JonasRadtke/GB-Akku/doc/connectorboard.jpg

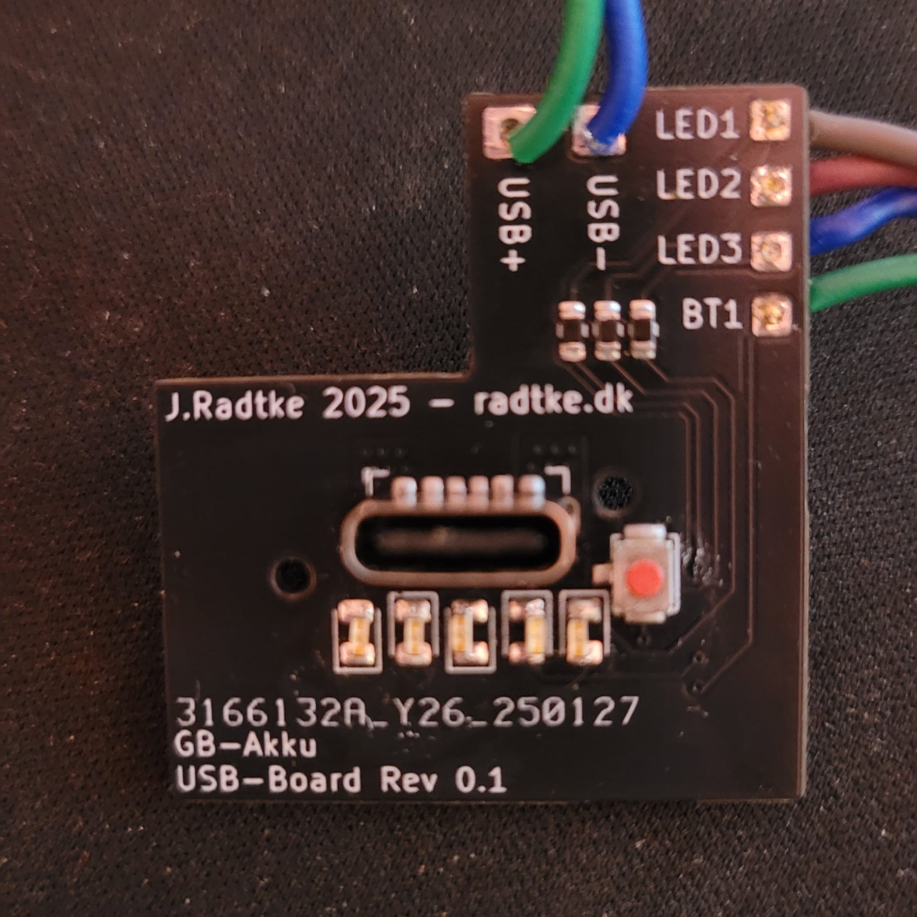
doc/connectorboard.jpg
