JonasRadtke/GB-Akku/doc/vorher.jpg

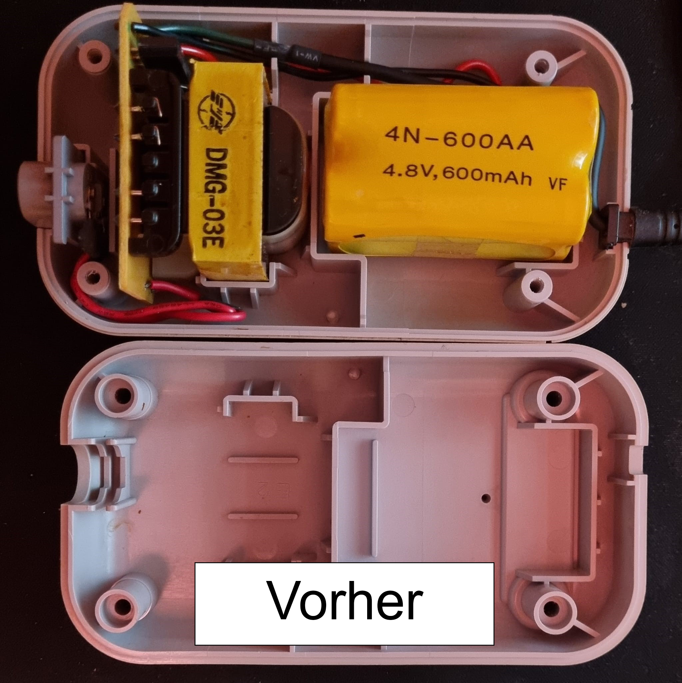
doc/vorher.jpg
