JonasRadtke/GB-Akku/doc/board.jpg

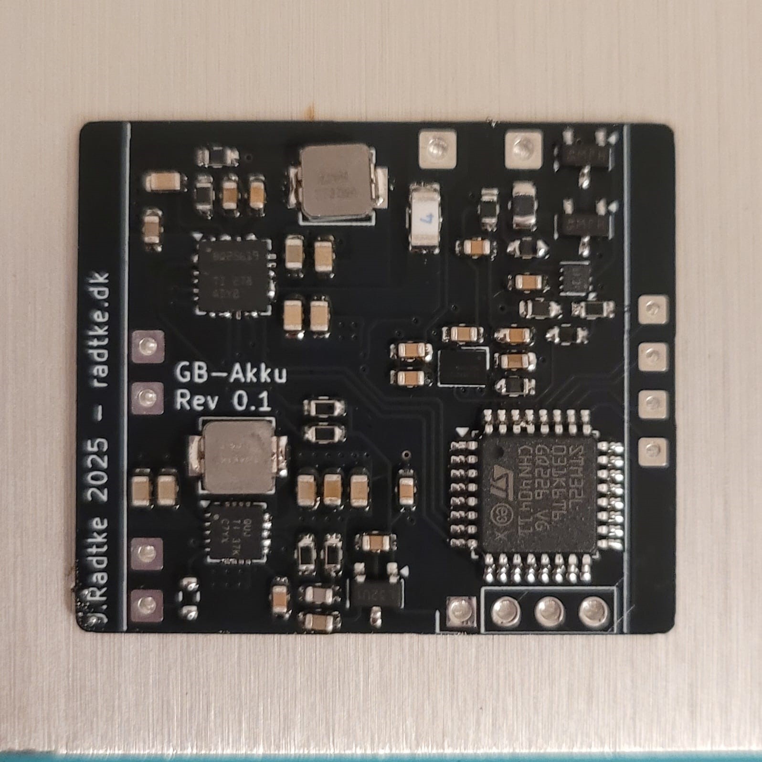
doc/board.jpg
