JonasRadtke/GB-Akku/doc/connector.jpg

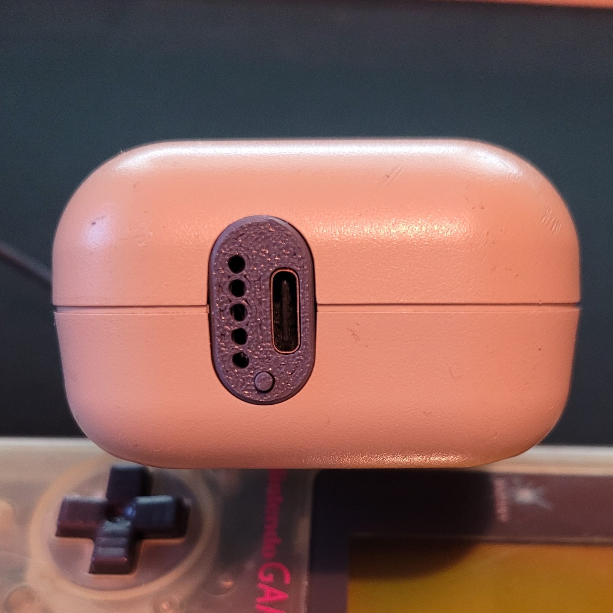
doc/connector.jpg
