JonasRadtke/GB-Akku/doc/nachher.jpg

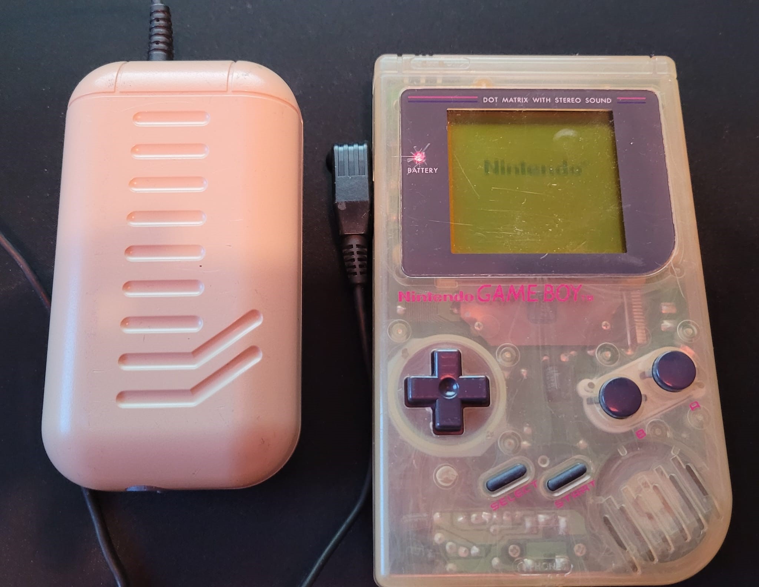
doc/nachher.jpg
