JonasRadtke/GB-Akku/doc/opend.jpg

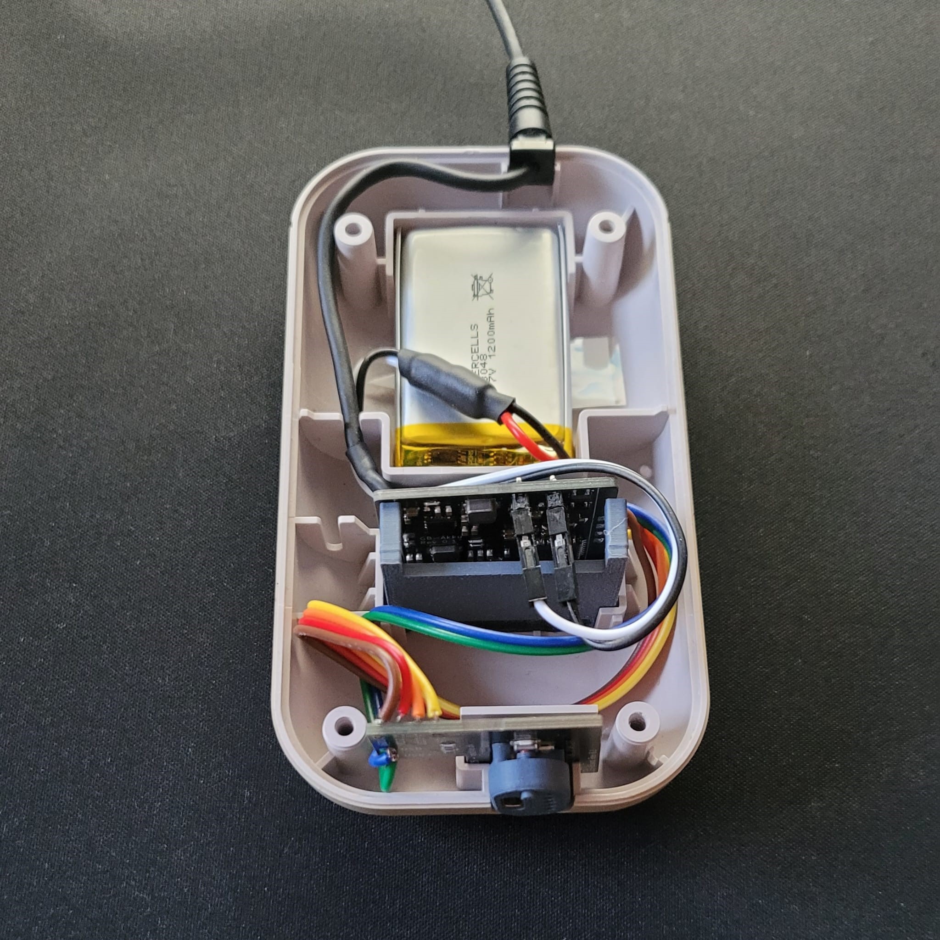
doc/opend.jpg
