JonasRadtke/GB-Akku/GB-Akku.kicad_pcb

## KiCad design GB-Akku.kicad_pcb (2025-02-14)

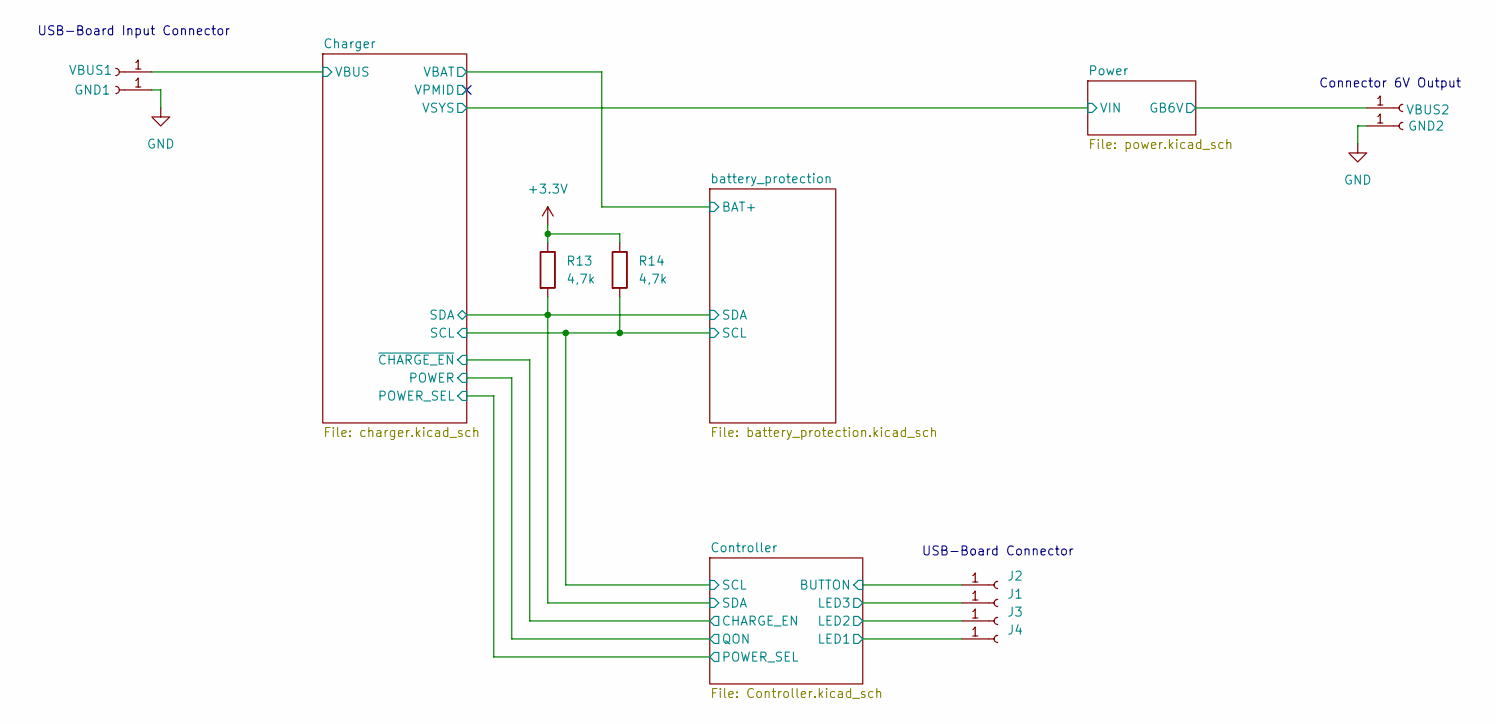
[picture p7: schematic GB-Akku.kicad_sch]

Parts:
GND1, GND2: +; SolderWire-0.25sqmm_1x01_D0.65mm_OD1.7mm
J1, J2, J3, J4: Conn_01x01_Socket; SolderWire-0.1sqmm_1x01_D0.4mm_OD1mm
R13, R14: 4,7k; R_0603_1608Metric
VBUS1, VBUS2: +; SolderWire-0.25sqmm_1x01_D0.65mm_OD1.7mm

Connections:
+3.3V: R13.1, R14.1; also elsewhere on the board
+6V: VBUS2.1; also elsewhere on the board
/Charger/SCL: R14.2; also elsewhere on the board
/Charger/SDA: R13.2; also elsewhere on the board
/Charger/VBUS: VBUS1.1; also elsewhere on the board
/Controller/BUTTON: J2.1; also elsewhere on the board
/Controller/LED1: J4.1; also elsewhere on the board
/Controller/LED2: J3.1; also elsewhere on the board
/Controller/LED3: J1.1; also elsewhere on the board
GND: GND1.1, GND2.1; also elsewhere on the board

Notes on the sheet:
Connector 6V Output
USB-Board Input Connector
USB-Board Connector

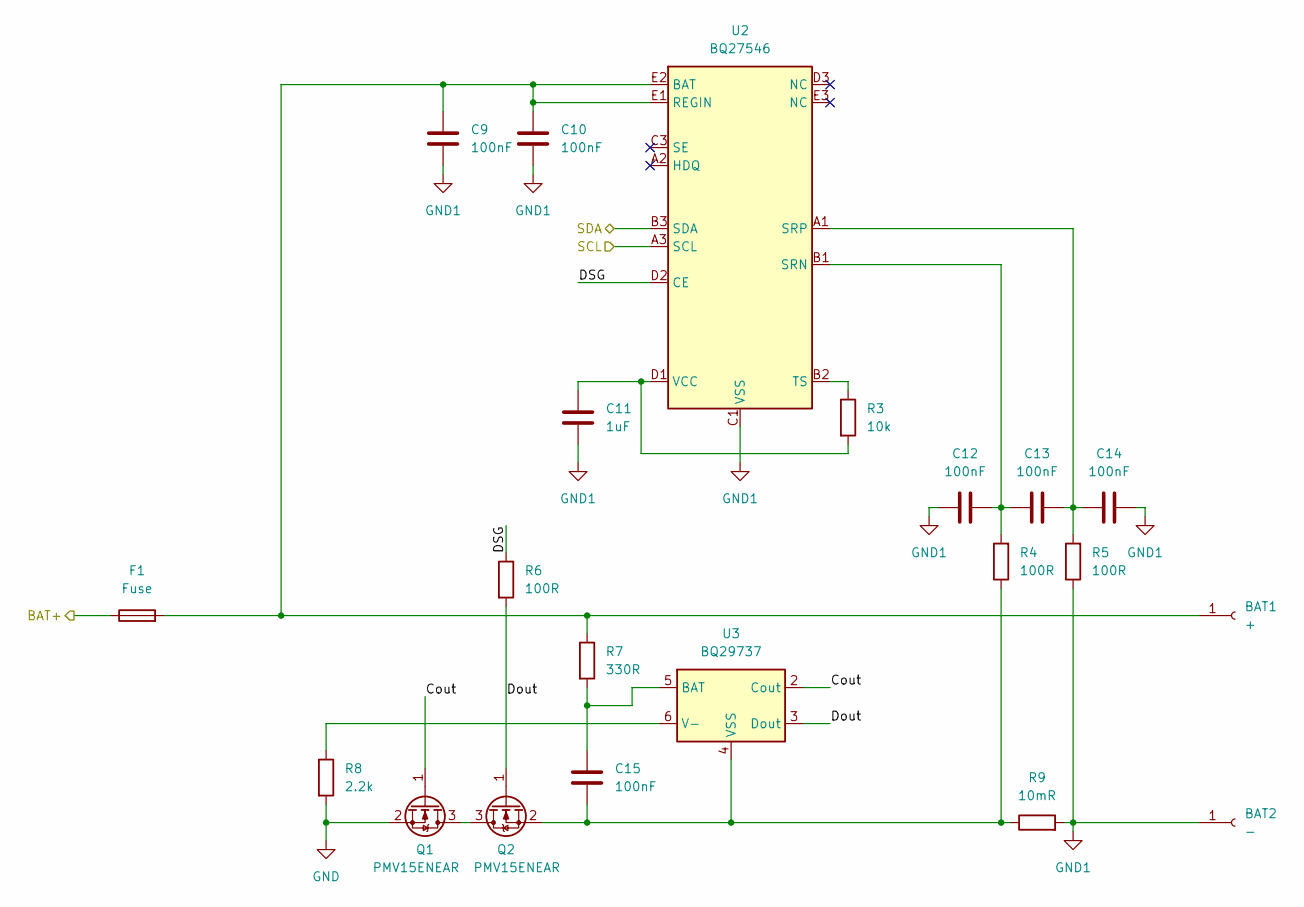
[picture p8: schematic battery_protection.kicad_sch]

Parts:
BAT1: +; SolderWire-0.5sqmm_1x01_D0.9mm_OD2.1mm
BAT2: -; SolderWire-0.5sqmm_1x01_D0.9mm_OD2.1mm
C9, C10, C12, C13, C14, C15: 100nF; C_0603_1608Metric
C11: 1uF; C_0603_1608Metric
F1: Fuse; Fuse_1206_3216Metric
Q1, Q2: PMV15ENEAR; SOT-23
R3: 10k; R_0603_1608Metric
R4, R5, R6: 100R; R_0603_1608Metric
R7: 330R; R_0603_1608Metric
R8: 2.2k; R_0603_1608Metric
R9: 10mR; R_0805_2012Metric
U2: BQ27546; DSBGA-15_1.95x2.6mm_P0.5mm_special
U3: BQ29737; WSON-6_1.5x1.5mm_P0.5mm

Connections:
/Charger/SCL: U2.A3 (SCL); also elsewhere on the board
/Charger/SDA: U2.B3 (SDA); also elsewhere on the board
/battery_protection/Cout: Q1.1 (G), U3.2 (Cout)
/battery_protection/DSG: R6.1, U2.D2 (CE)
/battery_protection/Dout: Q2.1 (G), R6.2, U3.3 (Dout)
BAT: F1.1; also elsewhere on the board
GND: Q1.2 (S), R8.2; also elsewhere on the board
GND1: BAT2.1, C9.2, C10.2, C11.2, C12.1, C14.2, R5.1, R9.2, U2.C1 (VSS), U2.C2 (VSS)
unnamed: BAT1.1, C9.1, C10.1, F1.2, R7.1, U2.E1 (REGIN), U2.E2 (BAT)
unnamed: Q1.3 (D), Q2.3 (D)
unnamed: C15.2, Q2.2 (S), R4.1, R9.1, U3.4 (VSS)
unnamed: C12.2, C13.1, R4.2, U2.B1 (SRN)
unnamed: C13.2, C14.1, R5.2, U2.A1 (SRP)
unnamed: R3.1, U2.B2 (TS)
unnamed: C11.1, R3.2, U2.D1 (VCC)
unnamed: C15.1, R7.2, U3.5 (BAT)
unnamed: R8.1, U3.6 (V-)

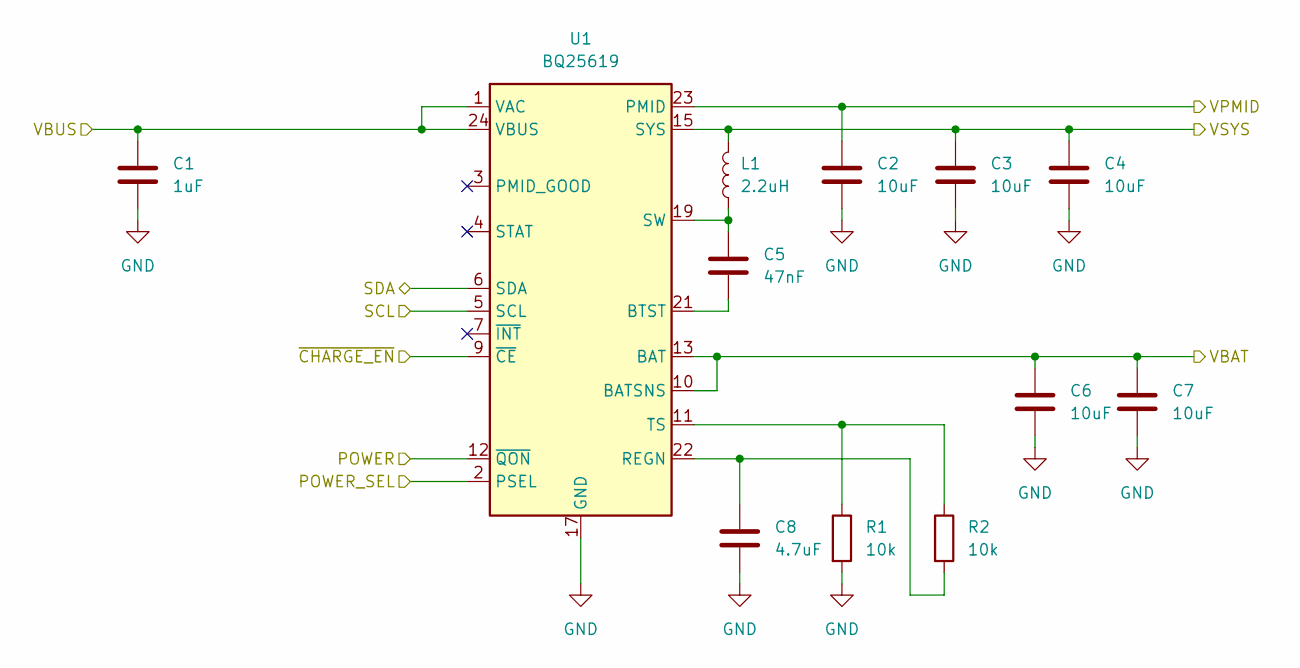
[picture p9: schematic charger.kicad_sch]

Parts:
C1: 1uF; C_0603_1608Metric
C2, C3, C4, C6, C7: 10uF; C_0603_1608Metric
C5: 47nF; C_0603_1608Metric
C8: 4.7uF; C_0603_1608Metric
L1: 2.2uH; L_Vishay_IHLP-1616
R1, R2: 10k; R_0603_1608Metric
U1: BQ25619; WQFN-24-1EP_4x4mm_P0.5mm_EP2.6x2.6mm_ThermalVias

Connections:
/Charger/POWER: U1.12 (~QON); also elsewhere on the board
/Charger/POWER_SEL: U1.2 (PSEL); also elsewhere on the board
/Charger/SCL: U1.5 (SCL); also elsewhere on the board
/Charger/SDA: U1.6 (SDA); also elsewhere on the board
/Charger/VBUS: C1.1, U1.1 (VAC), U1.24 (VBUS); also elsewhere on the board
/Charger/VPMID: C2.1, U1.23 (PMID)
/Charger/VSYS: C3.1, C4.1, L1.2, U1.15 (SYS), U1.16 (SYS); also elsewhere on the board
/Charger/~CHARGE_EN: U1.9 (~CE); also elsewhere on the board
BAT: C6.1, C7.1, U1.10 (BATSNS), U1.13 (BAT), U1.14 (BAT); also elsewhere on the board
GND: C1.2, C2.2, C3.2, C4.2, C6.2, C7.2, C8.2, R1.2, U1.17 (GND), U1.18 (GND), U1.25 (GND); also elsewhere on the board
unnamed: C5.1, L1.1, U1.19 (SW), U1.20 (SW)
unnamed: C5.2, U1.21 (BTST)
unnamed: C8.1, R2.2, U1.22 (REGN)
unnamed: R1.1, R2.1, U1.11 (TS)

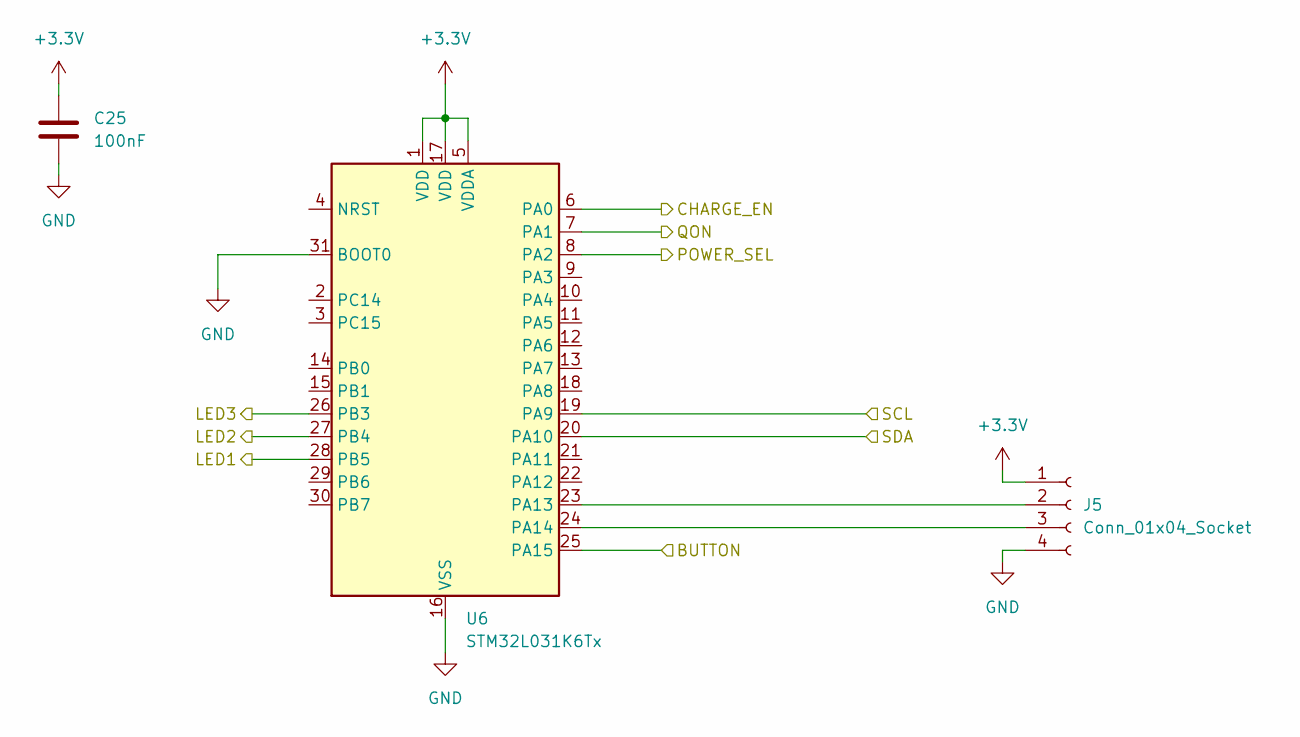
[picture p10: schematic Controller.kicad_sch]

Parts:
C25: 100nF; C_0603_1608Metric
J5: Conn_01x04_Socket; PinHeader_1x04_P2.54mm_Vertical
U6: STM32L031K6Tx; LQFP-32_7x7mm_P0.8mm

Connections:
+3.3V: C25.1, J5.1, U6.1 (VDD), U6.5 (VDDA), U6.17 (VDD); also elsewhere on the board
/Charger/POWER: U6.7 (PA1); also elsewhere on the board
/Charger/POWER_SEL: U6.8 (PA2); also elsewhere on the board
/Charger/SCL: U6.19 (PA9); also elsewhere on the board
/Charger/SDA: U6.20 (PA10); also elsewhere on the board
/Charger/~CHARGE_EN: U6.6 (PA0); also elsewhere on the board
/Controller/BUTTON: U6.25 (PA15); also elsewhere on the board
/Controller/LED1: U6.28 (PB5); also elsewhere on the board
/Controller/LED2: U6.27 (PB4); also elsewhere on the board
/Controller/LED3: U6.26 (PB3); also elsewhere on the board
GND: C25.2, J5.4, U6.16 (VSS), U6.31 (BOOT0), U6.32 (VSS); also elsewhere on the board
unnamed: J5.2, U6.23 (PA13)
unnamed: J5.3, U6.24 (PA14)

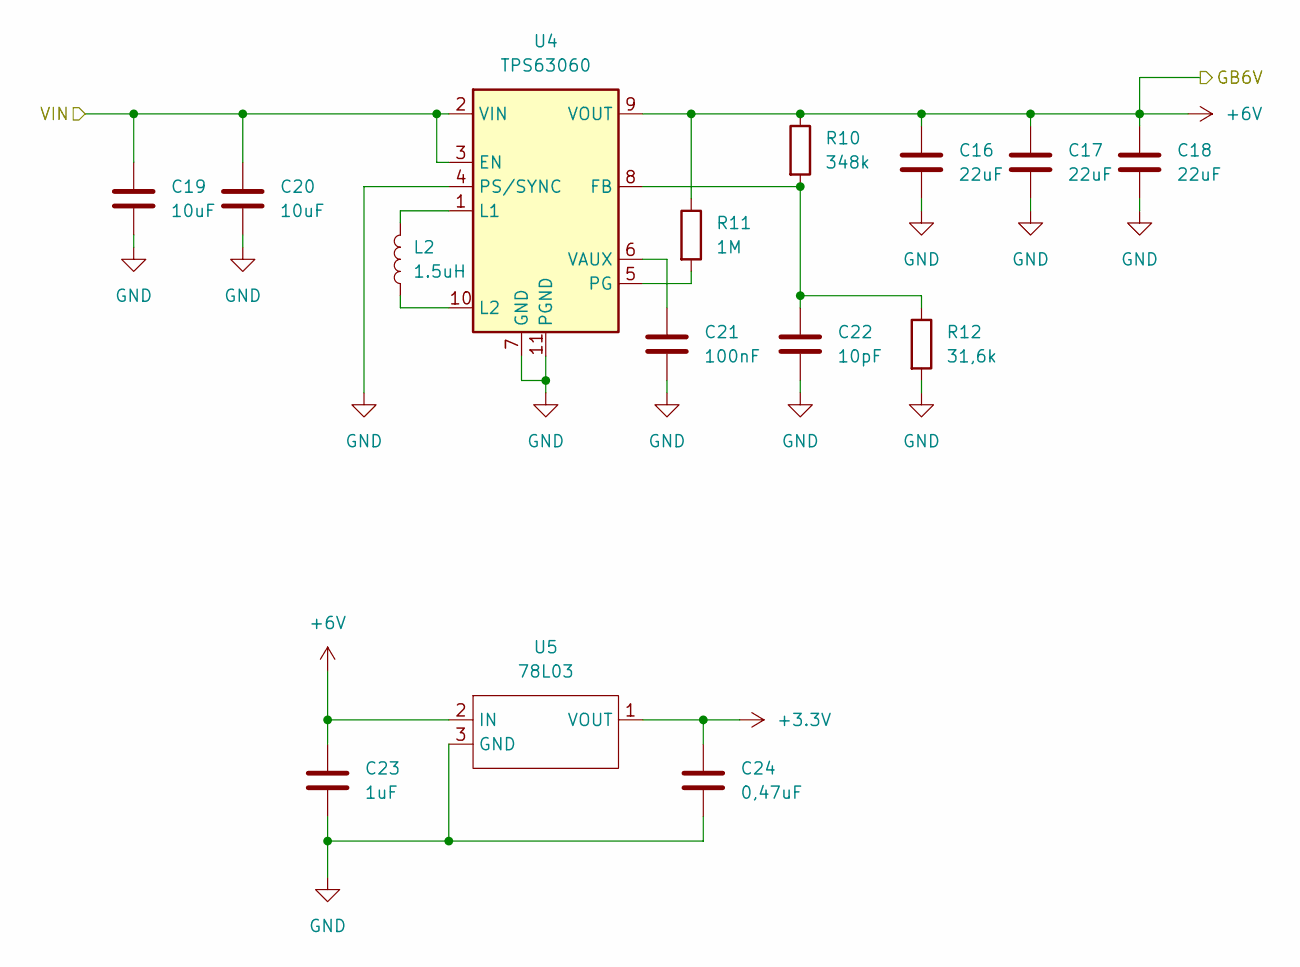
[picture p11: schematic power.kicad_sch]

Parts:
C16, C17, C18: 22uF; C_0603_1608Metric
C19, C20: 10uF; C_0603_1608Metric
C21: 100nF; C_0603_1608Metric
C22: 10pF; C_0603_1608Metric
C23: 1uF; C_0603_1608Metric
C24: 0,47uF; C_0603_1608Metric
L2: 1.5uH; L_Vishay_IHLP-1616
R10: 348k; R_0603_1608Metric
R11: 1M; R_0603_1608Metric
R12: 31,6k; R_0603_1608Metric
U4: TPS63060; Texas_S-PWSON-N10_ThermalVias
U5: 78L03; SOT-23-3

Connections:
+3.3V: C24.1, U5.1 (VOUT); also elsewhere on the board
+6V: C16.1, C17.1, C18.1, C23.1, R10.1, R11.1, U4.9 (VOUT), U5.2 (IN); also elsewhere on the board
/Charger/VSYS: C19.1, C20.1, U4.2 (VIN), U4.3 (EN); also elsewhere on the board
GND: C16.2, C17.2, C18.2, C19.2, C20.2, C21.2, C22.2, C23.2, C24.2, R12.2, U4.4 (PS/SYNC), U4.7 (GND), U4.11 (PGND), U5.3 (GND); also elsewhere on the board
unnamed: C22.1, R10.2, R12.1, U4.8 (FB)
unnamed: L2.2, U4.1 (L1)
unnamed: L2.1, U4.10 (L2)
unnamed: R11.2, U4.5 (PG)
unnamed: C21.1, U4.6 (VAUX)

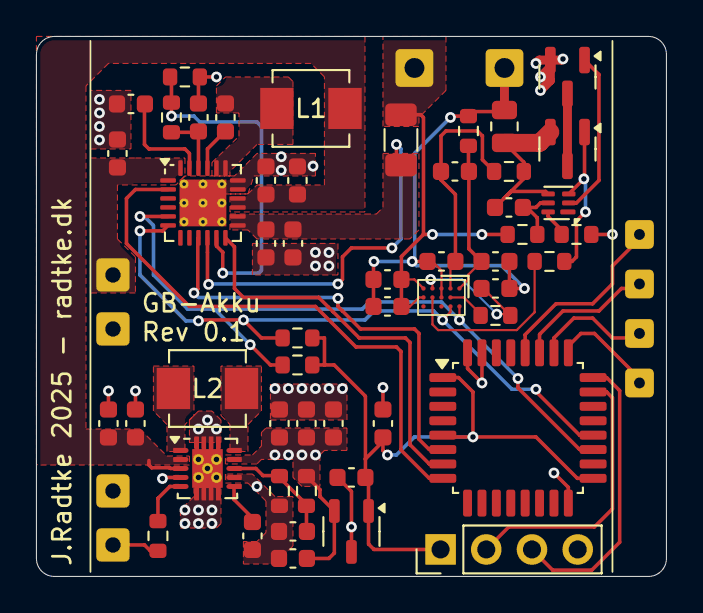
[picture p12: board GB-Akku.kicad_pcb from above]

Board: 2 copper layers, 35.0 x 30.0 mm, 61 parts (0 on the bottom side), 40 nets.
