JonasRadtke/GB-Akku/GB-Akku-USB-Board/GB-Akku-USB-Board.kicad_pcb

## KiCad design GB-Akku-USB-Board/GB-Akku-USB-Board.kicad_pcb (2025-01-26)

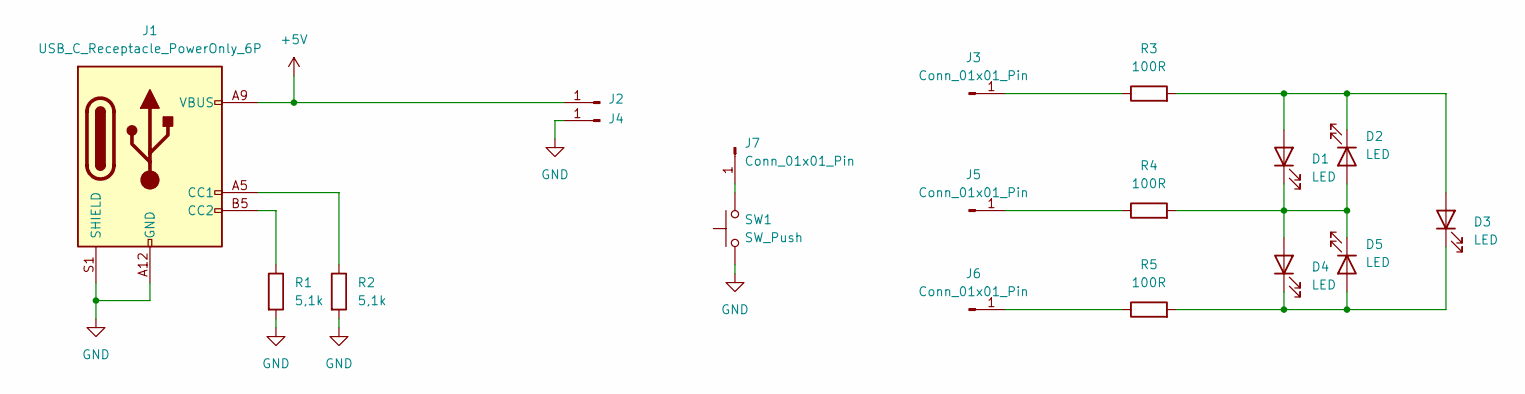
[picture p13: schematic GB-Akku-USB-Board.kicad_sch]

Parts:
D1, D2, D3, D4, D5: LED; LED_0805_2012Metric
J1: USB_C_Receptacle_PowerOnly_6P; UJC-V-G-SMT-P6-TR
J2, J4: Conn_01x01_Pin; SolderWire-0.5sqmm_1x01_D0.9mm_OD2.1mm
J3, J5, J6, J7: Conn_01x01_Pin; SolderWire-0.1sqmm_1x01_D0.4mm_OD1mm
R1, R2: 5,1k; R_0603_1608Metric
R3, R4, R5: 100R; R_0603_1608Metric
SW1: SW_Push; TL1017AABF260QG

Connections:
+5V: J1.A9 (VBUS), J1.B9 (VBUS), J2.1
GND: J1.A12 (GND), J1.B12 (GND), J1.S1 (SHIELD), J4.1, R1.2, R2.2, SW1.1
unnamed: D1.2 (A), D2.1 (K), D3.2 (A), R3.2
unnamed: D1.1 (K), D2.2 (A), D4.2 (A), D5.1 (K), R4.2
unnamed: D3.1 (K), D4.1 (K), D5.2 (A), R5.2
unnamed: J1.A5 (CC1), R2.1
unnamed: J1.B5 (CC2), R1.1
unnamed: J3.1, R3.1
unnamed: J5.1, R4.1
unnamed: J6.1, R5.1
unnamed: J7.1, SW1.2

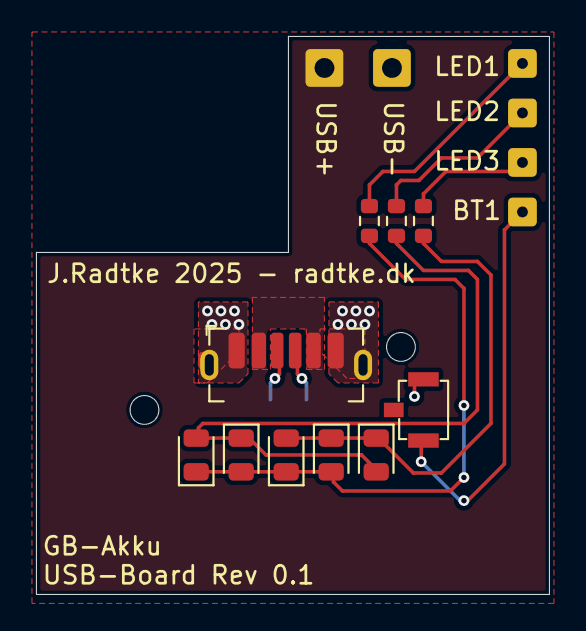
[picture p14: board GB-Akku-USB-Board.kicad_pcb from above]

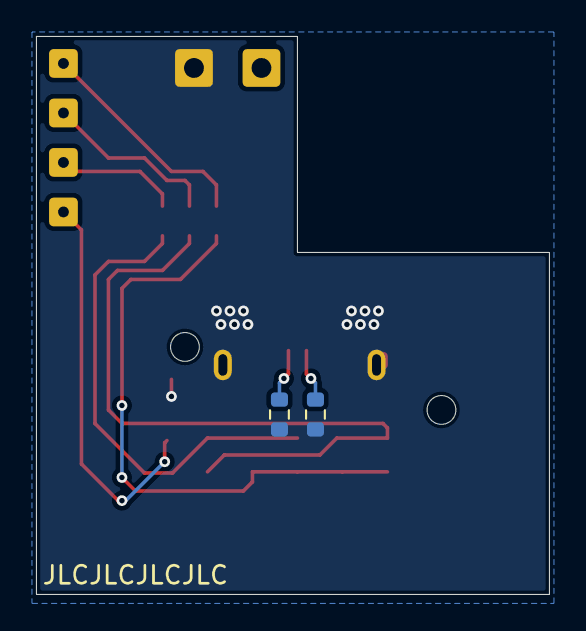
[picture p15: board GB-Akku-USB-Board.kicad_pcb from below]

Board: 2 copper layers, 28.5 x 31.0 mm, 18 parts (2 on the bottom side), 11 nets.
