JonasRadtke/GB-Akku/(commit log)

2025-01-26 Rev 0.1
    first order
    [Controller.kicad_sch, GB-Akku-USB-Board.kicad_pcb, GB-Akku-USB-Board.kicad_sch, GB-Akku.kicad_pcb, GB-Akku.kicad_sch, battery_protection.kicad_sch, charger.kicad_sch, power.kicad_sch]
2025-02-14 STM32 BOOT0 Pin fixed
    [Controller.kicad_sch, GB-Akku-USB-Board.kicad_sch, GB-Akku.kicad_pcb, GB-Akku.kicad_sch]
